AsociacionMakerAlicante/Taller_IoT-/README.md

Grupo de trabajo de internet de las cosas.

Carpeta LoRa4808: placa con ATmega4808 y RFM95W. Archivos hardware en Diptrace.
