AsociacionMakerAlicante/Taller_IoT-/LoRa4808/Hardware_Rev_0_2/LoRa_4808.ods

Quantity | RefDes | Value | Pattern | Part Number
6 | C1, C3, C5, C6, C7, C11 | 100n | CAP_0603 | CC0603KRX7R9BB104 (https://www.mouser.es/ProductDetail/YAGEO/CC0603KRX7R9BB104?qs=vTakOoo5QyLvVCYM2ge8LQ==)
2 | C2, C4 | 33u | CAP_0805 | C2012X5R1A336M125AC (https://www.mouser.es/ProductDetail/TDK/C2012X5R1A336M125AC)
2 | C8, C10 | 100n | CAP_0402 | CC0402KRX5R9BB104 (https://www.mouser.es/ProductDetail/YAGEO/CC0402KRX5R9BB104?qs=tS/AHvPQ/54XMwZ0cMoKQg==)
1 | C9 | 1u | CAP_0603 | C0603C105K8PACTU (https://www.mouser.es/ProductDetail/KEMET/C0603C105K8PACTU?qs=WeB8qxTbSWaetm26YMRPSw==)
1 | D1 |  | LED_0603 | APT1608SECK/J3-PRV (https://www.mouser.es/ProductDetail/Kingbright/APT1608SECK-J3-PRV?qs=D2TOvUWgdJ5TSyTRtB9vYw==)
1 | F1 |  | FUSE_0603 | SF-0603S070-2 (https://www.mouser.es/ProductDetail/Bourns/SF-0603S070-2)
1 | IC1 | RFM95W | RFM95W
1 | J1 |  | SMA_UFL_PAD | DNP
2 | J2, J5 |  | Pin header 12x2,54
1 | J4 |  | Pin header 2x3x2,54 | 61000621121 (https://www.mouser.es/ProductDetail/Wurth-Elektronik/61000621121?qs=PhR8RmCirEYoFU9UUO%2Bbug==)
1 | J6 |  | Pin header 2x2,54
1 | L1 |  | IND_0603 | BLM18KG221SN1D (https://www.mouser.es/ProductDetail/Murata-Electronics/BLM18KG221SN1D)
1 | Q1 | SI2329DS | Mosfet_P_sot23-3 | SI2329DS-T1-GE3 (https://www.mouser.es/ProductDetail/Vishay-Semiconductors/SI2329DS-T1-GE3)
4 | R1, R2, R3, R4 | 10k | RES_0603 | RCA060310K0FKEA (https://www.mouser.es/ProductDetail/Vishay-Draloric/RCA060310K0FKEA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)
1 | R5 | 1k | RES_0603 | CR0603AFX-1001ELF (https://www.mouser.es/ProductDetail/Bourns/CR0603AFX-1001ELF?qs=GedFDFLaBXGqdYDTGA+62g==)
1 | R7 | 22k (TBD) | RES_0603
1 | R6 | 100k | RES_0603 | CR0603AFX-1003EAS (https://www.mouser.es/ProductDetail/Bourns/CR0603AFX-1003EAS?qs=PzGy0jfpSMt3RNxQD3lIYw==)
1 | U1 |  | SOP-28 | ATMEGA4808-XU (https://www.mouser.es/ProductDetail/Microchip-Technology-Atmel/ATMEGA4808-XU?qs=P1JMDcb91o5OO/yk9Wa7Zw==)
1 | U2 |  | TPL5010 | TPL5010QDDCTQ1 (https://www.mouser.es/ProductDetail/595-TPL5010QDDCTQ1)
30
