AsociacionMakerAlicante/Taller_IoT-/LoRa4808/Hardware_Rev_0_2/LoRa4808_Rev_0_2.pdf

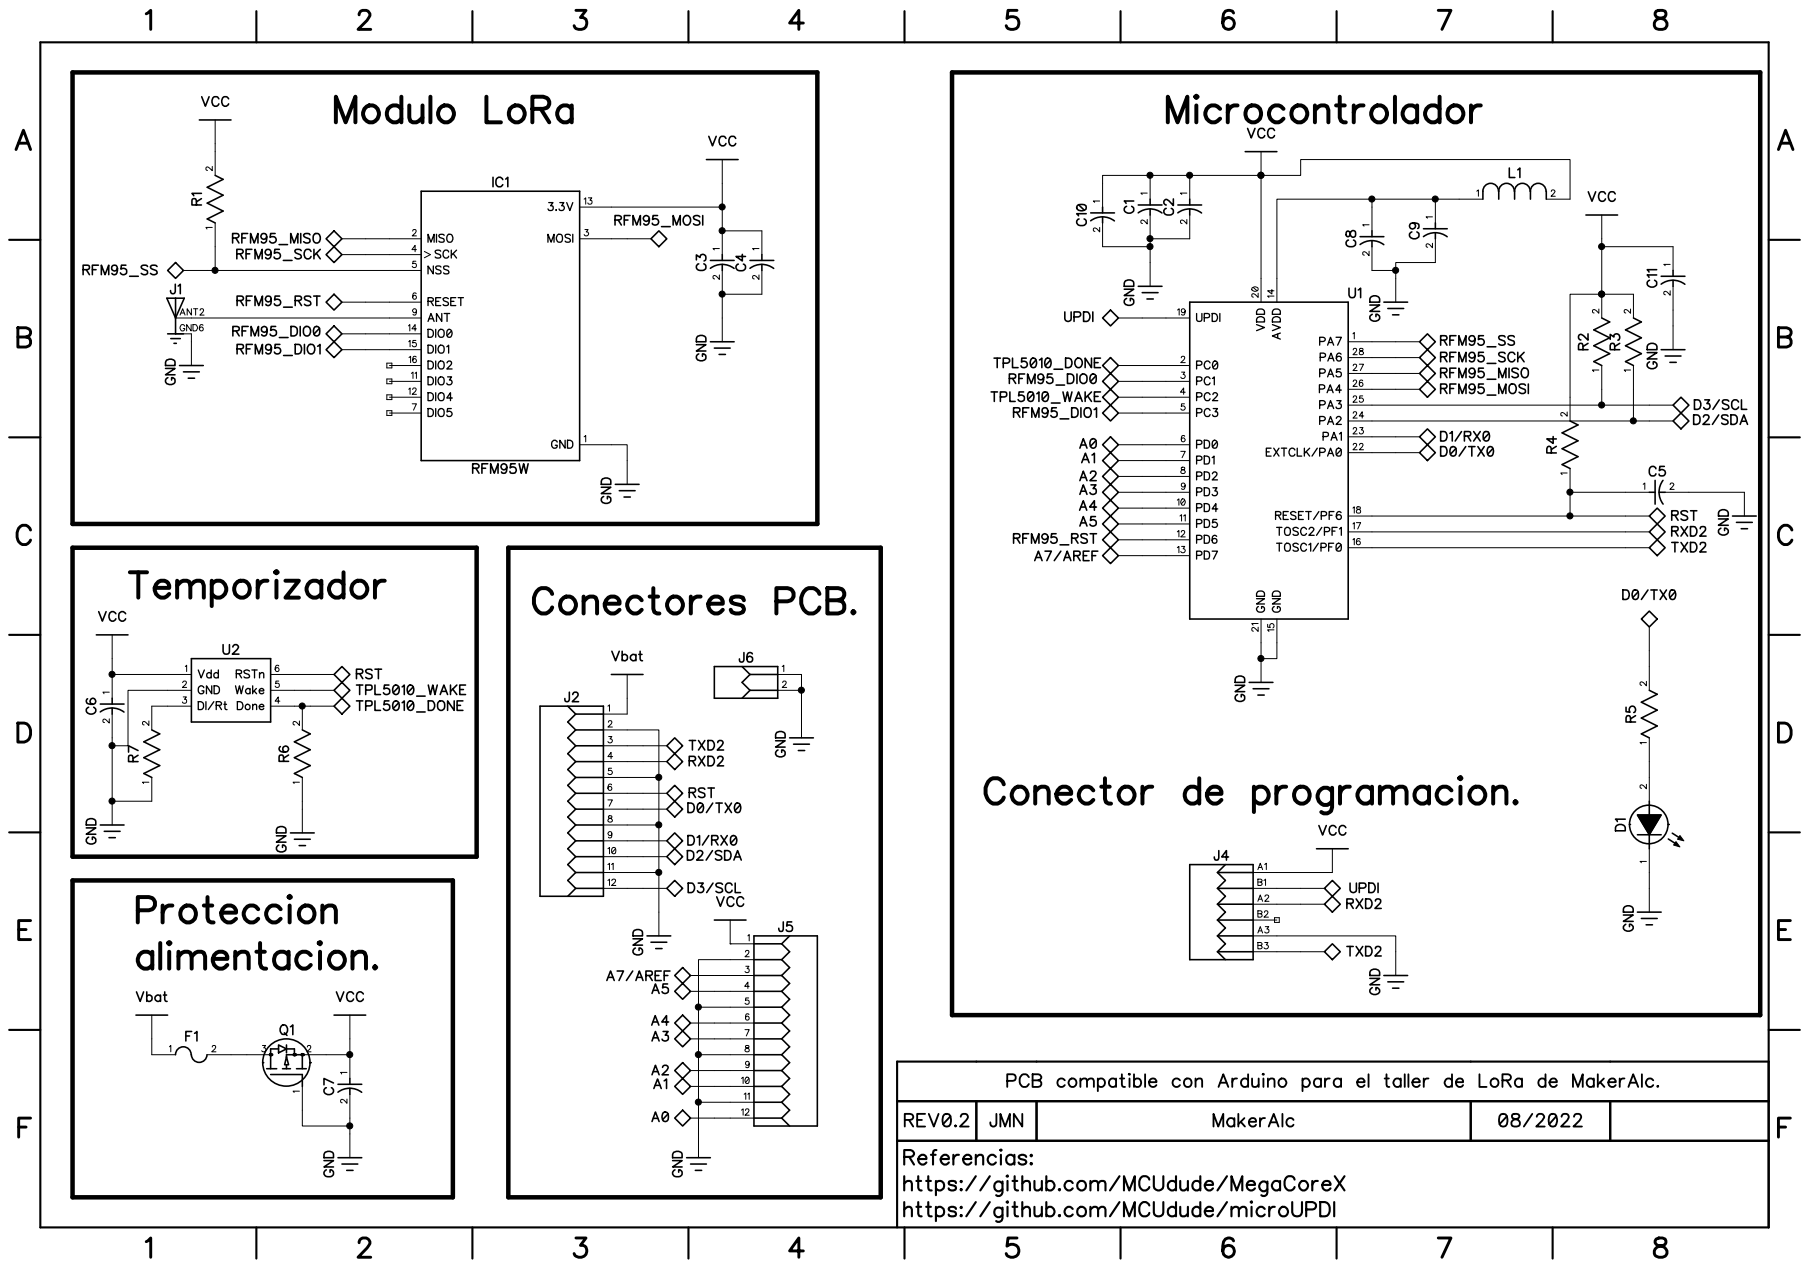
[picture p6: page 1]
