AsociacionMakerAlicante/Taller_IoT-/(list of files, drawings)

Other design files:
LoRa4808/Hardware_Rev_0_2/LoRa_4808.dch
LoRa4808/Hardware_Rev_0_2/LoRa_4808.dip
