AsociacionMakerAlicante/Taller_IoT-/Sesiones_2022/Ejemplo_Lectura_Bateria/dispositivos.h

/*
*Claves e identificadores de cada uni de los dispositivos que creamos en la red Helium.
*DEVEUI APPEUI en LSB, APPKEY en MSB.
*/

#ifndef DISPOSITIVOS_H
#define DISPOSITIVOS_H

#define DEVEUI_DISPOSITIVO_01 0xFF.... Añadir los identificadores generados para cada
#define APPEUI_DISPOSITIVO_01 0xFF.... dispositivo en la consola de Helium
#define APPKEY_DISPOSITIVO_01 0xFF....

#endif
