AsociacionMakerAlicante/Taller_IoT-/(commit log)

2022-09-14 Hardware LoRa4808 Rev 0.2
    [LoRa_4808.dch, LoRa_4808.dip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]
2022-09-22 Fichero con definición de pines de la placa LoRa.
    Copiar este fichero en el directorio "include" de los proyectos con la placa Lora.
    Para incluir este fichero en los proyectos solo hay que poner #include <Pines.h>
2022-09-22 Como configurar los programas para esta placa.
2022-10-07 Helium
    Programa básico para conectar con Helium
2022-10-07 Actualización de comentarios
2022-11-17 Ejemplo para leer el nivel batería con el ADC sin pines.
2022-11-17 Comentada la línea que selecciona la versión de la placa
